BIT-SGC/ZW1S-hardware/Readme.md

# ZW1S 7inch/5inch Quadcopter Upper Board

> silence is gold
