BIT-SGC/ZW1S-hardware/(commit log)

2025-07-25 暂存: 基本完成原理图(未分配封装，未ERC)
    [VIN-5V0-SBC.kicad_sch, ZW1S.kicad_sch, mcu.kicad_sch, mechanic.kicad_sch, plug.kicad_sch, power.kicad_sch, usb.kicad_sch]
2025-07-25 暂存: 基本完成原理图(差雷达接口)
    [VIN-5V0-SBC.kicad_sch, ZW1S.kicad_pcb, ZW1S.kicad_sch, mcu.kicad_sch, mechanic.kicad_sch, plug.kicad_sch, power.kicad_sch, usb.kicad_sch]
2025-07-26 暂存: 布局布线基本完成(DRC未过，GND不全)
    [VIN-5V0-SBC.kicad_sch, ZW1S.kicad_pcb, mcu.kicad_sch, plug.kicad_sch, power.kicad_sch, usb.kicad_sch]
2025-07-27 提交生产: 2507271646
    [ZW1S.kicad_pcb]
2025-08-13 fix: 修正TPS54302反馈电阻值
    [ZW1S.kicad_pcb, power.kicad_sch]
2025-08-25 pref: USB外设改自供电，优化布线
    [VIN-5V0-SBC.kicad_sch, ZW1S.kicad_pcb, mcu.kicad_sch, plug.kicad_sch, power.kicad_sch, usb.kicad_sch]
